RHall09/R8-O7/src/docs/html/MotorSpecs.png

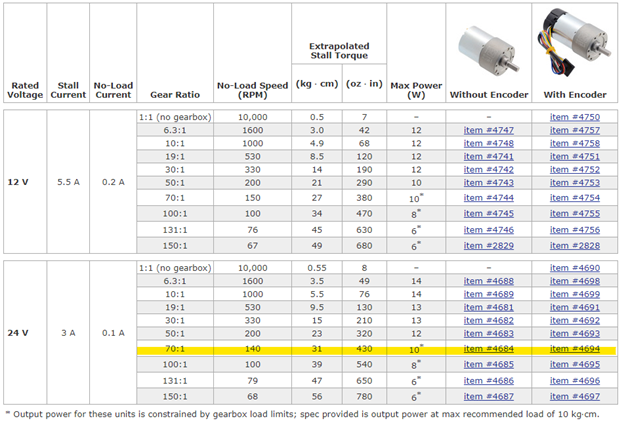
src/docs/html/MotorSpecs.png
