RHall09/R8-O7/src/Images/IMG_20211207_150913048.jpg

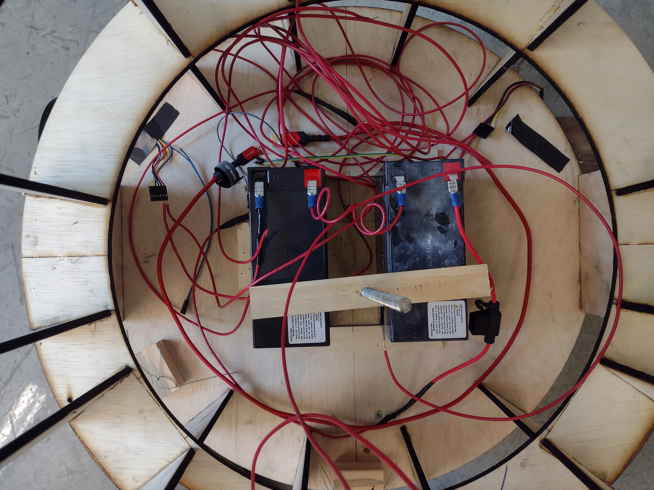
src/Images/IMG_20211207_150913048.jpg
