RHall09/R8-O7/README.md

R8-O7

A repository containing source code for running an autonomous crowd interaction robot.

See https://rhall09.github.io/R8-O7/html/index.html#sec_intro for documentation and inspirations.
