RHall09/R8-O7/src/docs/html/BabyBot.png

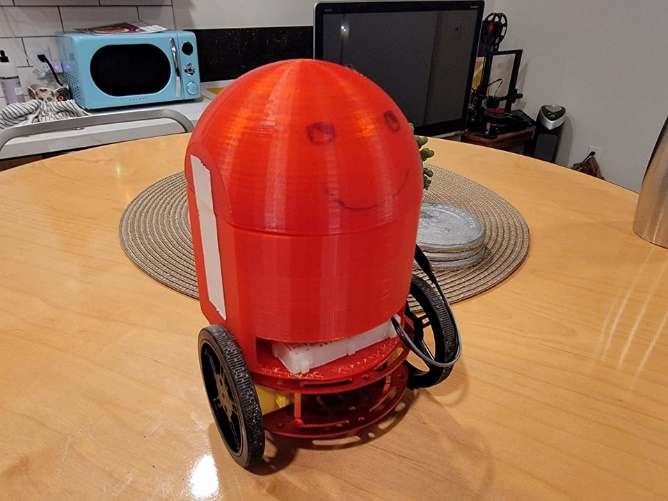
src/docs/html/BabyBot.png
