RHall09/R8-O7/src/docs/html/BluetoothGUI.png

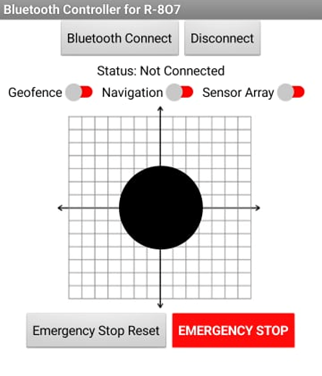
src/docs/html/BluetoothGUI.png
