RHall09/R8-O7/src/docs/html/BoardwSections.png

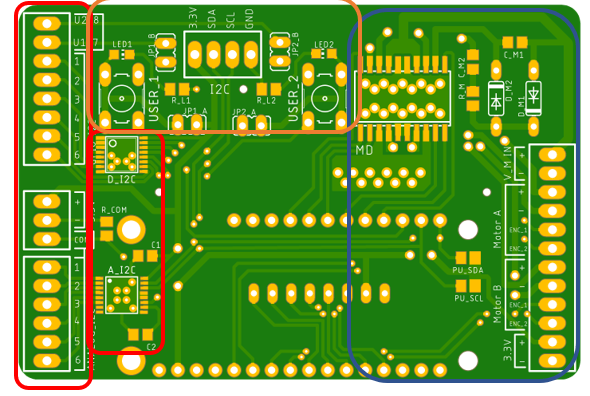
src/docs/html/BoardwSections.png
