RHall09/R8-O7/src/docs/html/BodyFrame.png

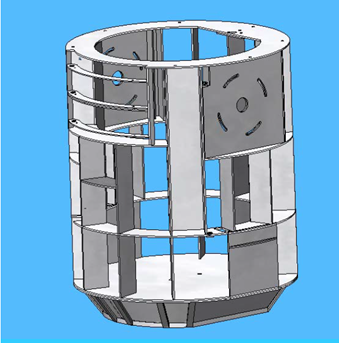
src/docs/html/BodyFrame.png
