RHall09/R8-O7/src/docs/html/CurvaturefromFence.png

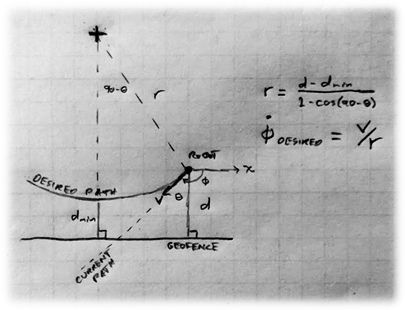
src/docs/html/CurvaturefromFence.png
