RHall09/R8-O7/src/docs/html/GeofenceTriangles.png

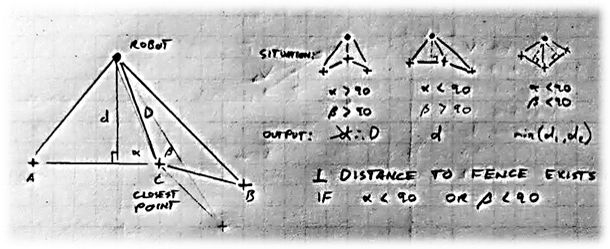
src/docs/html/GeofenceTriangles.png
