RHall09/R8-O7/src/docs/html/J4K3.png

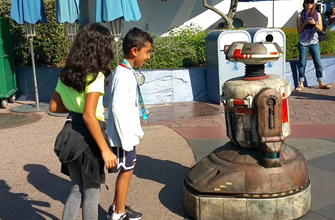
src/docs/html/J4K3.png
