RHall09/R8-O7/src/docs/html/MITCode.png

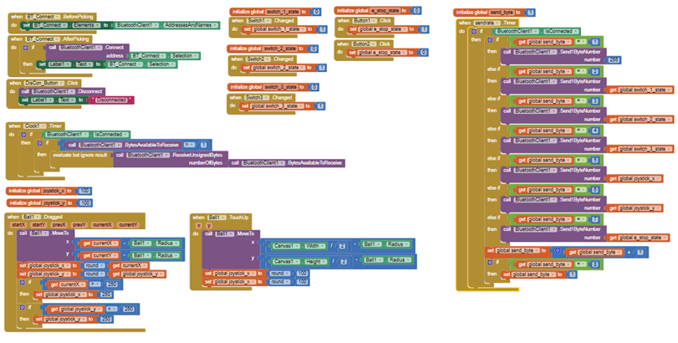
src/docs/html/MITCode.png
