RHall09/R8-O7/src/docs/html/R5Example.jpg

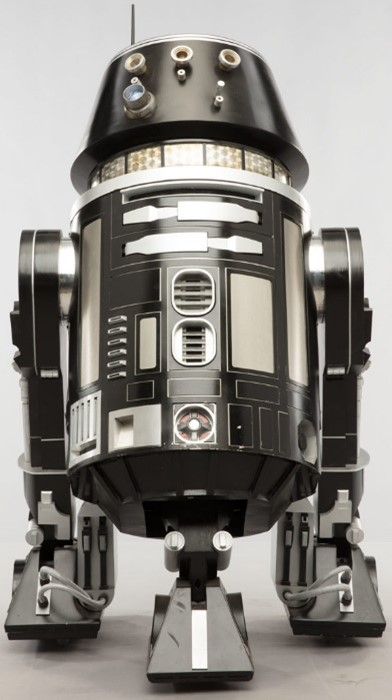
src/docs/html/R5Example.jpg
