RHall09/R8-O7/src/docs/html/TaskDiagram.png

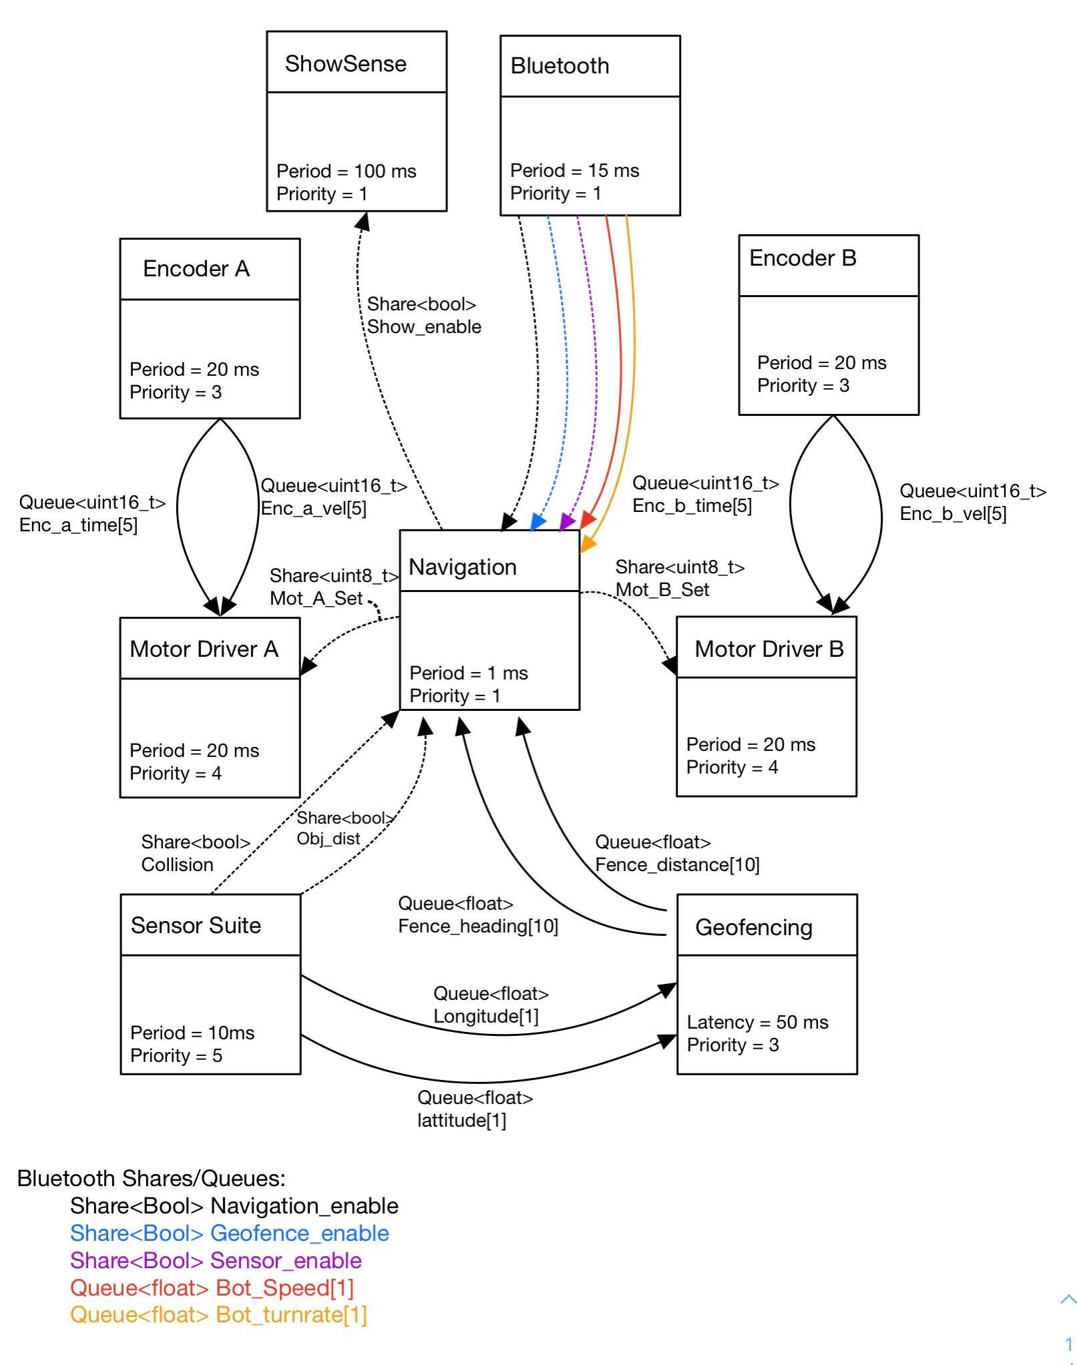
src/docs/html/TaskDiagram.png
