RHall09/R8-O7/src/Images/IMG_20211207_150856646.jpg

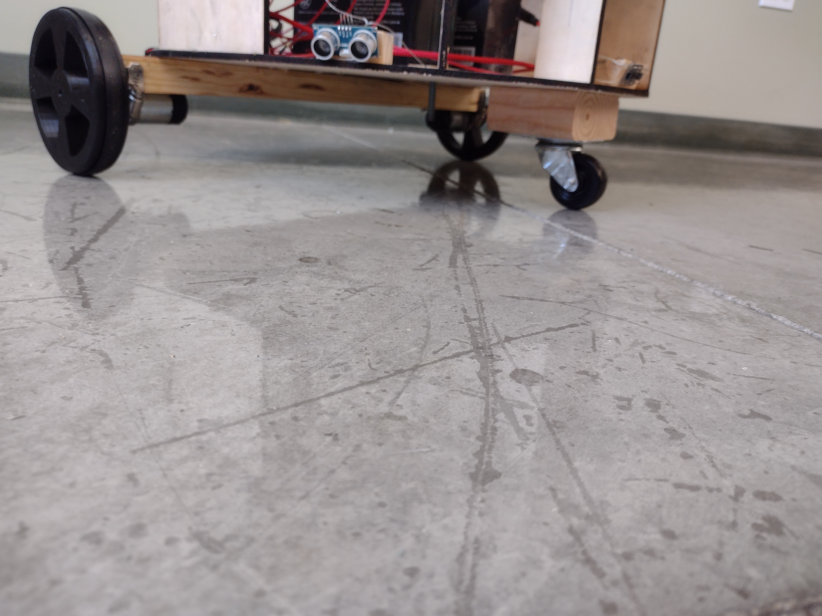
src/Images/IMG_20211207_150856646.jpg
