RHall09/R8-O7/src/Images/IMG_20211207_150905897.jpg

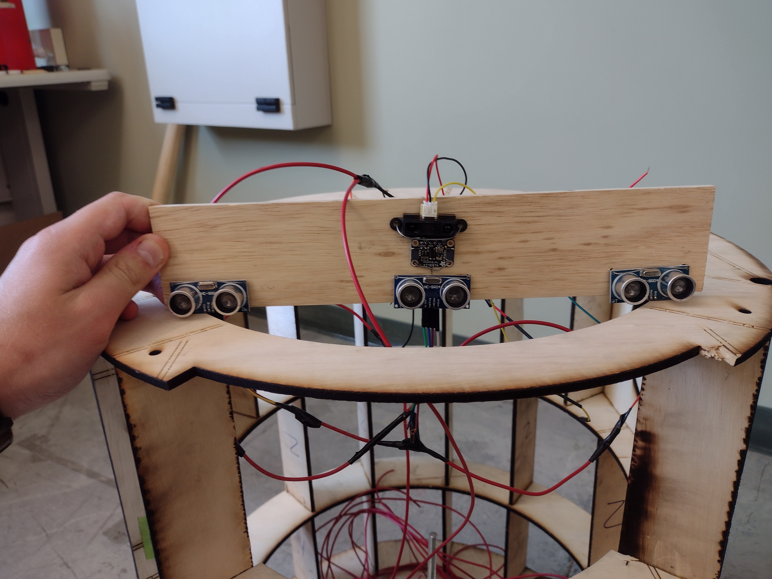
src/Images/IMG_20211207_150905897.jpg
