RHall09/R8-O7/board/R8-o7.brd

## EAGLE design board/R8-o7.brd (2021-11-02)

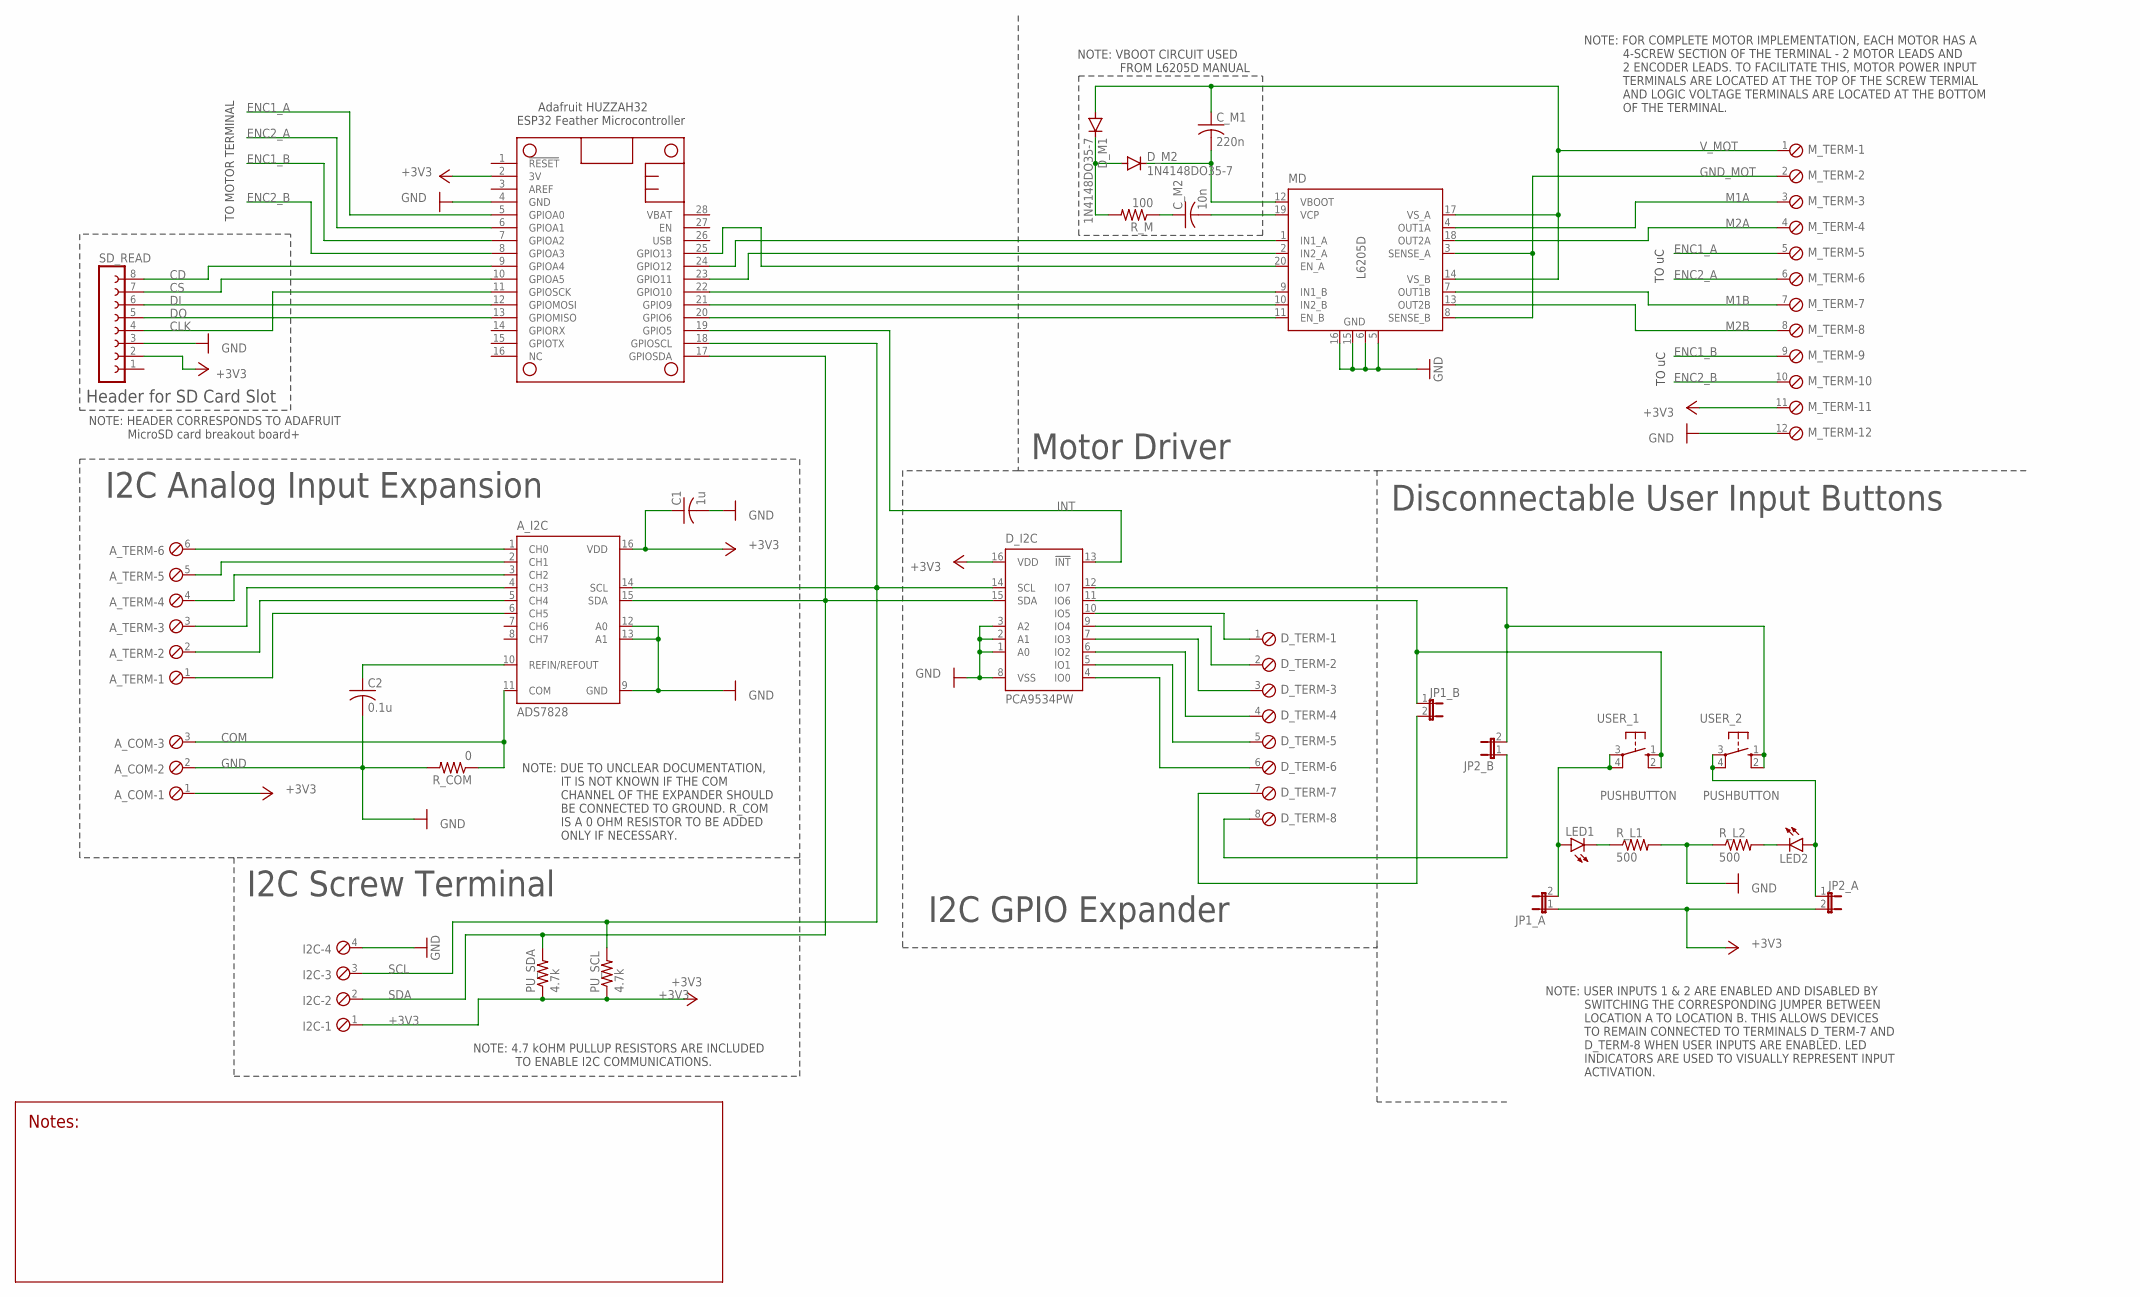
[picture p15: schematic R8-o7.sch]

Parts:
A_COM: SCREWTERM_3P_254; 3POL254
A_I2C: ADS7828; TSSOP16-PW
A_TERM: SCREWTERM_6P_254; 6POL254
C1: 1u; C0805
C2: 0.1u; C0805
C_M1: 220n; C0805
C_M2: 10n; C0805
D_I2C: PCA9534PW; TSSOP16
D_M1, D_M2: 1N4148DO35-7; DO35-7
D_TERM: SCREWTERM_8P_254; 8POL254
FTHRWNG: FEATHERWINGEXTENDED_BOTH_ENDS; FEATHERWING
I2C: SCREWTERM_4P_254; 4POL254
JP1_A, JP1_B, JP2_A, JP2_B: JP1E; JP1
LED1, LED2: LEDCHIP-LED0805; CHIP-LED0805
MD: L6205D; SO20
M_TERM: SCREWTERM_12P_254; 12POL254
PU_SCL: 4.7k; M0805
PU_SDA: 4.7k; M0805
R_COM: 0; M0805
R_L1, R_L2: 500; M0805
R_M: 100; M0805
SD_READ: FE08-1; FE08
USER_1, USER_2: PUSHBUTTON; B3F-10XX

Connections:
+3V3: A_COM.1, A_I2C.16 (VDD), C1.1, D_I2C.16 (VDD), FTHRWNG.2 (3V), I2C.1, JP1_A.1, JP2_A.2, M_TERM.11, PU_SCL.1, PU_SDA.1, SD_READ.2
CD: FTHRWNG.9 (GPIOA4), SD_READ.8
CLK: FTHRWNG.11 (GPIOSCK), SD_READ.4
COM: A_COM.3, A_I2C.11 (COM), R_COM.1
CS: FTHRWNG.10 (GPIOA5), SD_READ.7
DI: FTHRWNG.12 (GPIOMOSI), SD_READ.6
DO: FTHRWNG.13 (GPIOMISO), SD_READ.5
ENC1_A: FTHRWNG.5 (GPIOA0), M_TERM.5
ENC1_B: FTHRWNG.7 (GPIOA2), M_TERM.9
ENC2_A: FTHRWNG.6 (GPIOA1), M_TERM.6
ENC2_B: FTHRWNG.8 (GPIOA3), M_TERM.10
GND: A_COM.2, A_I2C.9 (GND), A_I2C.12 (A0), A_I2C.13 (A1), C1.2, C2.2, D_I2C.1 (A0), D_I2C.2 (A1), D_I2C.3 (A2), D_I2C.8 (VSS), FTHRWNG.4 (GND), I2C.4, MD.5 (GND), MD.6 (GND), MD.15 (GND), MD.16 (GND), M_TERM.12, R_COM.2, R_L1.2, R_L2.1, SD_READ.3
GND_MOT: MD.3 (SENSE_A), MD.8 (SENSE_B), M_TERM.2
INT: D_I2C.13 (!INT), FTHRWNG.19 (GPIO5)
M1A: MD.4 (OUT1A), M_TERM.3
M1B: MD.7 (OUT1B), M_TERM.7
M2A: MD.18 (OUT2A), M_TERM.4
M2B: MD.13 (OUT2B), M_TERM.8
unnamed: D_I2C.12 (IO7), JP2_B.2, USER_2.1 (S), USER_2.2 (S1)
unnamed: D_I2C.11 (IO6), JP1_B.1, USER_1.1 (S), USER_1.2 (S1)
unnamed: D_I2C.10 (IO5), D_TERM.1
unnamed: D_I2C.9 (IO4), D_TERM.2
unnamed: D_I2C.7 (IO3), D_TERM.3
unnamed: D_I2C.6 (IO2), D_TERM.4
unnamed: D_TERM.7, JP1_B.2
unnamed: A_I2C.1 (CH0), A_TERM.6
unnamed: A_I2C.2 (CH1), A_TERM.5
unnamed: A_I2C.3 (CH2), A_TERM.4
unnamed: A_I2C.4 (CH3), A_TERM.3
unnamed: A_I2C.5 (CH4), A_TERM.2
unnamed: A_I2C.6 (CH5), A_TERM.1
unnamed: A_I2C.10 (REFIN/REFOUT), C2.1
unnamed: FTHRWNG.20 (GPIO6), MD.11 (EN_B)
unnamed: FTHRWNG.21 (GPIO9), MD.10 (IN2_B)
unnamed: FTHRWNG.22 (GPIO10), MD.9 (IN1_B)
unnamed: FTHRWNG.23 (GPIO11), MD.2 (IN2_A)
unnamed: FTHRWNG.24 (GPIO12), MD.1 (IN1_A)
unnamed: FTHRWNG.25 (GPIO13), MD.20 (EN_A)
unnamed: JP1_A.2, LED1.A, USER_1.3, USER_1.4 (P1)
unnamed: JP2_A.1, LED2.A, USER_2.3, USER_2.4 (P1)
unnamed: LED1.C, R_L1.1
unnamed: LED2.C, R_L2.2
unnamed: D_I2C.5 (IO1), D_TERM.5
unnamed: D_I2C.4 (IO0), D_TERM.6
unnamed: D_TERM.8, JP2_B.1
unnamed: C_M2.1, R_M.1
unnamed: D_M1.C, D_M2.A, R_M.2
SCL: A_I2C.14 (SCL), D_I2C.14 (SCL), FTHRWNG.18 (GPIOSCL), I2C.3, PU_SCL.2
SDA: A_I2C.15 (SDA), D_I2C.15 (SDA), FTHRWNG.17 (GPIOSDA), I2C.2, PU_SDA.2
VBOOT: C_M1.2, D_M2.C, MD.12 (VBOOT)
VCP: C_M2.2, MD.19 (VCP)
V_MOT: C_M1.1, D_M1.A, MD.14 (VS_B), MD.17 (VS_A), M_TERM.1

Notes on the sheet:
NOTE: VBOOT CIRCUIT USED FROM L6205D MANUAL
NOTE: USER INPUTS 1 & 2 ARE ENABLED AND DISABLED BY SWITCHING THE CORRESPONDING JUMPER BETWEEN LOCATION A TO LOCATION B. THIS ALLOWS DEVICES TO REMAIN CONNECTED TO TERMINALS D_TERM-7 AND D_TERM-8 WHEN USER INPUTS ARE ENABLED. LED INDICATORS ARE USED TO VISUALLY REPRESENT INPUT ACTIVATION.
Motor Driver
Disconnectable User Input Buttons
Header for SD Card Slot
NOTE: HEADER CORRESPONDS TO ADAFRUIT MicroSD card breakout board+
I2C GPIO Expander
I2C Screw Terminal
NOTE: 4.7 kOHM PULLUP RESISTORS ARE INCLUDED TO ENABLE I2C COMMUNICATIONS.
I2C Analog Input Expansion
Adafruit HUZZAH32 ESP32 Feather Microcontroller
NOTE: DUE TO UNCLEAR DOCUMENTATION, IT IS NOT KNOWN IF THE COM CHANNEL OF THE EXPANDER SHOULD BE CONNECTED TO GROUND. R_COM IS A 0 OHM RESISTOR TO BE ADDED ONLY IF NECESSARY.
NOTE: FOR COMPLETE MOTOR IMPLEMENTATION, EACH MOTOR HAS A 4-SCREW SECTION OF THE TERMINAL - 2 MOTOR LEADS AND 2 ENCODER LEADS. TO FACILITATE THIS, MOTOR POWER INPUT TERMINALS ARE LOCATED AT THE TOP OF THE SCREW TERMIAL AND LOGIC VOLTAGE TERMINALS ARE LOCATED AT THE BOTTOM OF THE TERMINAL.
TO MOTOR TERMINAL
TO uC

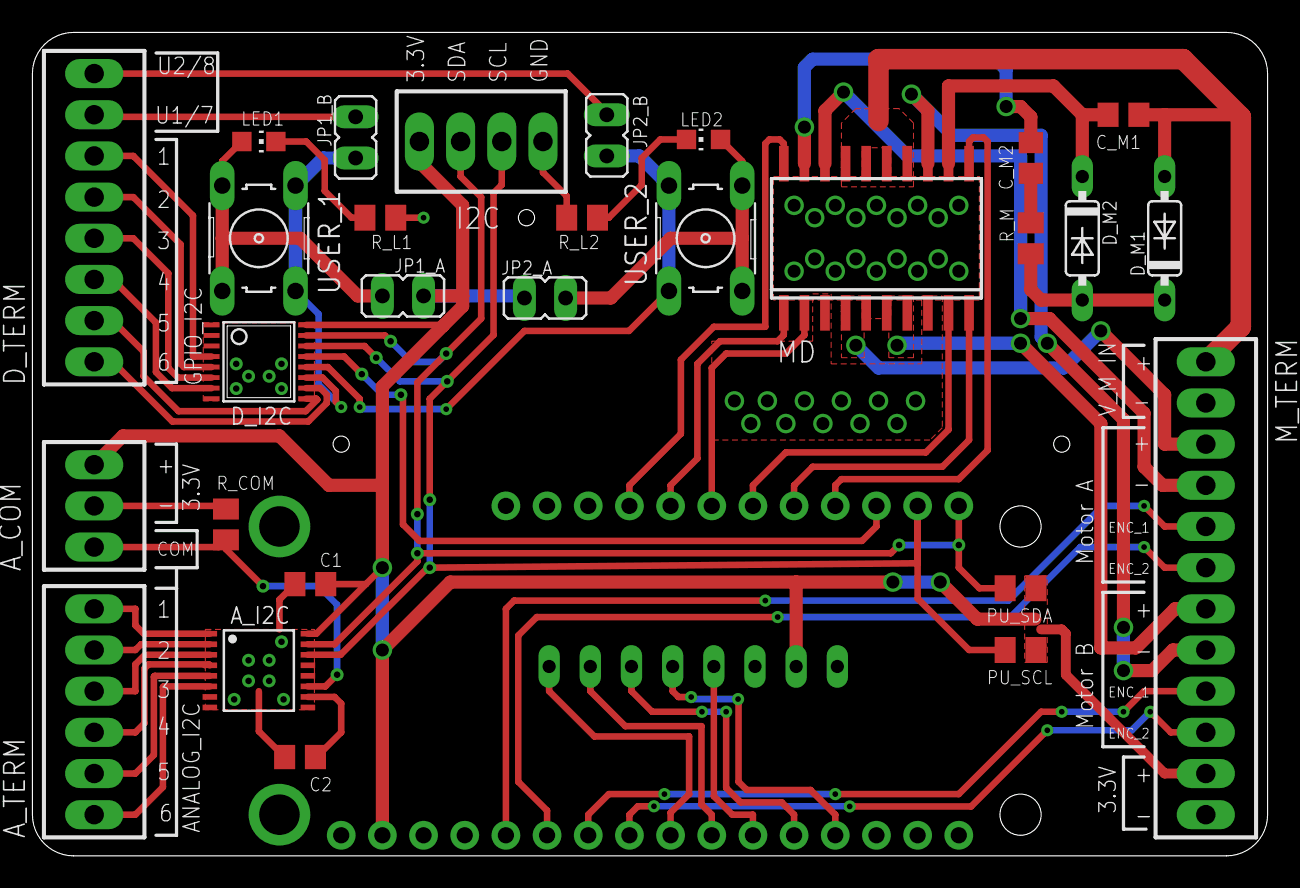
[picture p16: board R8-o7.brd from above]

Board: 2 copper layers, 76.2 x 50.8 mm, 30 parts (1 on the bottom side), 52 nets.
