RHall09/R8-O7/src/Motor_Drivers/Motor.cpp

/** @file Motor.cpp
 *  @brief Drives a motor when fed a PWM signal (+/-)
 *  @details     This file contains the member functions of a class designed to drive a motor with two PWM signals
 *      and an enable pin. This class does \b NOT implement a control loop; it simply commands the 
 *      appropriate PWM to the motor.
 * 
 * 
 *  @author Rick Hall
 *  @date 2020-4-Nov
 *  @copyright (c) 2021 by Rick Hall, released under the LGPL 3.0.
 */

#include <Arduino.h>
#include <PrintStream.h>
#include <Motor.h>

//Constructor Function

Motor::Motor(int Pin_En, int Pin_1, int Pin_2, Motor_Number mot_num)
{
    // Store motor pins 
    PinE = Pin_En;
    Pin1 = Pin_1;
    Pin2 = Pin_2;

    // For each motor, the channels will be 2*mot_num and 2*mot_num + 1
    motor_channel_1 = mot_num;
    motor_channel_2 = motor_channel_1 + 1;

    // Set pins to output mode & confirm pins set low
    pinMode(PinE, OUTPUT);
    digitalWrite(PinE, LOW);

    ledcAttachPin(Pin1, motor_channel_1);
    ledcSetup(motor_channel_1, 30000, 8);
    ledcWrite(motor_channel_1, 0);

    ledcAttachPin(Pin2, motor_channel_2);
    ledcSetup(motor_channel_2, 30000, 8);
    ledcWrite(motor_channel_2, 0);

}

//Enable Motors
void Motor::enable(void)
{
    digitalWrite(PinE, HIGH);
    enabled = true;
}
//Disable Motors
void Motor::disable(void)
{
    digitalWrite(PinE, LOW);
    enabled = false;
}
//Set both motor behaviors with PWM %s
void Motor::set(int16_t pwm)
{
    if ( (mot_error == 0) && (enabled == 1) )
    {
        uint16_t absPwm = (uint16_t)abs(pwm);

        if( (0 < pwm) && (pwm <= 255) )
        {
            ledcWrite(motor_channel_2, 0);
            ledcWrite(motor_channel_1, absPwm);

        }
        else if( (-255 <= pwm) && (pwm < 0) )
        {
            ledcWrite(motor_channel_1, 0);
            ledcWrite(motor_channel_2, absPwm);

        }
        else
        {
            ledcWrite(motor_channel_1, 0);
            ledcWrite(motor_channel_2, 0);

        } 

    }
}
//Set individual motor behavior with PWM %s
//Stop motors
void Motor::stop(void)
{
    ledcWrite(motor_channel_1, 0);
    ledcWrite(motor_channel_2, 0);
}

//Set error-overcurrent flag
void Motor::checkOvercurrent(void)
{
    if(!(digitalRead(PinE)))
    {
        mot_error = 1;
        ledcWrite(motor_channel_1, 0);
        ledcWrite(motor_channel_2, 0);   
        this -> disable();
    }
}
//Clear error-overcurrent flag
void Motor::clearOvercurrent(void)
{
    mot_error = 0;
    this -> enable();
}


//Check Flags
bool Motor::FlagChk(MotFlag flag)
{
    if(flag == ERROR)
    {
        return mot_error;
    }
    else
    {
        return enabled;
    }

}
