RHall09/R8-O7/src/Motor_Drivers/InterruptEncoder.cpp

/**  @file InterruptEncoder.cpp
 *   @brief		Member functions of a dependency of the \ref ESP32Encoder class. Allows for operation of encoders with interrupt service routines.
 *   @date Oct 8, 2020
 *   @author hephaestus
 **/


#include "InterruptEncoder.h"
void IRAM_ATTR encoderAISR(void * arg) {
	InterruptEncoder* object=(InterruptEncoder*)arg;
	long start = micros();
	long duration=start - object->microsLastA;
	if (duration >= US_DEBOUNCE) {
		object->microsLastA = start;
		object->microsTimeBetweenTicks=duration;
		object->aState = digitalRead(object->apin);
		object->bState = digitalRead(object->bpin);
		if (object->aState == object->bState)
			object->count++;
		else
			object->count--;
	}
}
InterruptEncoder::InterruptEncoder() {}
InterruptEncoder::~InterruptEncoder() {
	if(attached)
		detachInterrupt(digitalPinToInterrupt(apin));
}
int64_t  InterruptEncoder::read(){
	return count*2;
}
void InterruptEncoder::attach(int aPinNum, int bPinNum) {
	if(attached)
		return;
	apin = aPinNum;
	bpin = bPinNum;
	pinMode(apin, INPUT_PULLUP);
	pinMode(bpin, INPUT_PULLUP);
	attachInterruptArg(digitalPinToInterrupt(apin), encoderAISR,this, CHANGE);
}
