RHall09/R8-O7/src/Motor_Drivers/InterruptEncoder.h

/**  @file InterruptEncoder.h
 *   @brief		Member functions of a dependency of the \ref ESP32Encoder class. Allows for operation of encoders with interrupt service routines.
 *   @date Oct 8, 2020
 *   @author hephaestus
 **/

#ifndef INTERRUPTENCODER_H_
#define INTERRUPTENCODER_H_

#define MAX_ENCODERS 16
#define US_DEBOUNCE 10
#include <Arduino.h>

class InterruptEncoder {
private:
bool attached=false;



public:

	int apin=0;
	int bpin=0;
	InterruptEncoder();
	virtual ~InterruptEncoder();
	void attach(int aPinNum, int bPinNum);
	volatile bool aState=0;
	volatile bool bState=0;
	volatile int64_t count=0;
	volatile int64_t microsLastA=0;
	volatile int64_t microsTimeBetweenTicks=0;
	int64_t read();
};

#endif /* INTERRUPTENCODER_H_ */
