RHall09/R8-O7/src/Navigation_Drivers/nav_module.cpp

/** @file nav_module.cpp
 *  @brief   This file contains the member functions of a class for naturally driving the bot within a geofence. This class provides all motor set points unless overriden by the Bluetooth control task.
 *  @author Rick Hall
 *  @date 2021-4-Nov
 *  @copyright (c) 2021 by Rick Hall, released under the LGPL 3.0.
 **/

#include <Arduino.h>
#include <Navigation_Drivers/nav_module.h>
#include <cmath>


Navigation::Navigation(float v_cal, float t_cal)
{
    // Initialize Variables
    motor_set_A = 0;
    motor_set_B = 0;

    v_calibration = v_cal;
    t_calibration = t_cal;
}

void Navigation::nav_conv(float set_velocity, float set_turnrate)
{
    // Using calibration constants, compute motor PWM
    motor_set_A = (int16_t)round(set_velocity * v_calibration);
    motor_set_B = (int16_t)round(set_velocity * v_calibration);

    motor_set_A -= (int16_t)round(set_turnrate * t_calibration);
    motor_set_B += (int16_t)round(set_turnrate * t_calibration);

    // Overflow protection
    if ( (-255 > motor_set_A) | (motor_set_A < 255) )
    {
        if(0 <= motor_set_A)
        {
            motor_set_A = 255;
        }
        else
        {
            motor_set_A = -255;
        }
    }
    if ( (-255 > motor_set_B) | (motor_set_B < 255) )
    {
        if(0 <= motor_set_B)
        {
            motor_set_B = 255;
        }
        else
        {
            motor_set_B = -255;
        }
    }

}

int16_t Navigation::nav_A(void)
{
    return motor_set_A;
}

int16_t Navigation::nav_B(void)
{
    return motor_set_B;
}
