RHall09/R8-O7/(commit log)

2021-10-14 updated to force serial monitor speed and include adafruit motor shield library from github source
2021-10-14 updates to geobaby bot to include Adafruit MotorDriver featherwing class. Current issues with PWMServoDriver inclusion and compiling error.
    [main.cpp]
2021-10-14 Initial Draft of PCB Pin Expansion Board
    PCB project folder with schematic and board files. Many schematic errors, mostly used for verification of preliminary part sizing. If possible, larger I2C chips should be found.
    [PCB_Draft_0.brd, PCB_Draft_0.sch]
2021-10-14 With connected 3V and GND pins this time
    [PCB_Draft_0.sch]
2021-10-14 Addition of two major functionality changes: 1) allow for reading of an analog pin off the proximity sensor to measure distance to objects. 2) organize major motion profiles into functions for easy c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
    [main.cpp]
2021-10-14 Added I2C Headers
    [PCB_Draft_0.brd, PCB_Draft_0.sch]
2021-10-14 Update to baby bot: he works! This update includes averaging of IR readings to discourage random errors. Also randomized the turn radius on collision detection
    [main.cpp]
2021-10-15 Expanded board, reorganized stuff, added motor driver
    Submitted to canvas
    [PCB_Draft_0.brd, PCB_Draft_0.sch]
2021-10-18 Revert prox test to prox from battery test
    [main.cpp]
2021-10-19 Restarted schematic on larger sheet format. Added second motor driver
    [PCB_Draft_0.brd, PCB_Draft_1.brd, PCB_Draft_1.sch]
2021-10-19 Added components for MD bootstrap voltage circuit
    [PCB_Draft_1.sch]
2021-10-20 Updated main and .ini to include TinyGPS and some time modules for experimenting with nonblocking avoidance based on running time instead of delays.
    [main.cpp]
2021-10-20 Reduced to 1 MD, Airwire routing for MD
    [PCB_Draft_2.brd, PCB_Draft_2.sch]
2021-10-20 MD Screwterm labels & optimizations
    [PCB_Draft_2.brd, PCB_Draft_2.sch]
2021-10-21 BaseGPSTest: repush to fix mistake from last night. BabyGeoBot: Updated natural avoiding to function less blocky, passed parameters in, and added GPS functionality. NO geofence in place (yet)
    [main.cpp]
2021-10-21 Initial commit of UltrasonicTest materials. Queries using Arduino library HC-SR04 ultrasonic sensor
2021-10-22 Near-final draft - all wires run; checking formatting
    [PCB_Draft_2.brd, PCB_Draft_2.sch, PCB_Draft_3.brd, PCB_Draft_3.sch, PCB_Draft_4.brd, PCB_Draft_4.sch]
2021-10-22 Final-ish Version - for review
    [PCB_Draft_4.brd, PCB_Draft_4.sch]
2021-10-22 Final Version - Submitted to Canvas
    [R8-o7.brd, R8-o7.sch]
2021-10-25 Formatted .ini file and first pass at function for printing booleans! Using bit operator method since "device" is unspecified....?
2021-10-25 Semi-functional version of print_array. Sends something to the command line but not the array...
2021-10-25 Functioning version of print_array and a nice little test main.cpp Functions properly, but still want to check doxygen and float limitations
2021-10-25 Initial Commit of driver for digital i2c chip. Contains a base outline of class i2cdig with some basic constructors for debugging and the outline of some basic functions. Need to investigate what the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
2021-10-25 Initial commit of an attempt at an i2c test. Still need to set up nucleo as slave to fully test.
2021-10-26 My Anaconda Don't 🐍🐍🐍
    want none hun
2021-10-28 First draft of i2c.ccp driver. functions to: configure ports read input ports write output ports Untested.
2021-10-28 Including .h file for completed digital_i2c driver. Should be formatted correctly between .cpp and .h now
    [digital_i2c.cpp, digital_i2c.h, main.cpp]
2021-10-28 Introduction of analog_i2c files and administrative changes to digital i2c
2021-10-28 End of lab updates to start of analog driver. No major changes
2021-11-01 More Program Design & SD card stuff
    [CPPLINT.cfg]
2021-11-02 Folder Management
    [PCB_Draft_0.brd, PCB_Draft_0.sch, PCB_Draft_1.brd, PCB_Draft_1.sch, PCB_Draft_2.brd, PCB_Draft_2.sch, PCB_Draft_3.brd, PCB_Draft_3.sch]
2021-11-04 Version 1 of analog i2c drivers. Need refinement in readinput command
2021-11-19 Auto stash before revert of "Assignment Stuff"
    [main.cpp]
2021-11-26 As promised, geofencing header. Currently only has one function in it
2021-11-27 Fixed issue with EVER declaration
    [geofence_task.cpp]
2021-11-28 Push from tired kai. Not finished but updates the GPS from the featherwing. Need to give it the rest of the sensors. Should probably test the drivers before writing them into this task??? Ugh.
2021-11-28 This version has all the code to run 3 ultrasonic sensors and one of the time of flight sensors for the safety suite. It MUST be a priority task because the ultrasonic code is blocking.
2021-11-29 Lots of motor related stuff
2021-11-29 File management stuff
    (Put all driver test files in a single folder)
2021-11-29 Tasks moved into single project. Drivers not yet moved
2021-11-29 Drivers ported to project; some fixes in geofence code
    [Motor.cpp, Motor.h, MotorCS.cpp, MotorCS.h, analog_i2c.cpp, digital_i2c.cpp, digital_i2c.h, geofence_task.cpp]
2021-11-29 Updated the .gitignore to include a bunch of files that do not need to be traced. Will be adding more shortly
2021-11-29 Updated motor task code + file management
2021-11-29 Fixed error in including the wrong header in .cpp and created header for sensor_suite task.
    [sensor_suite_task.cpp, sensor_suite_task.h]
2021-11-30 Basic setup of navigation task Added boolean shares to sensor suite and geofence for toggling off for bluetooth control
2021-11-30 Fixed a comment error in digital_i2c Navigation task now reads from the appropriate queues in the sensor suite. Want to discuss # of readings and need overwrite directly to motor task if collision is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
    [digital_i2c.cpp, navigation_task.cpp]
2021-12-01 Encoder test.... i hope ...
2021-12-01 Motor drivers from when I stopped screwing with them. Nothing really works right now...
2021-12-01 Motor stuff?
2021-12-02 New motor test project
2021-12-02 Why doesn't this work
    [MotorCS.cpp]
2021-12-02 Bluetooth updates from Kai's fix
    [main.cpp]
2021-12-05 Updates to doxygen comments for I2C chip drivers.
2021-12-06 Added headers to InterruptEncoder class. No declaration of individual functions at this time.
2021-12-06 Commented MotorCS.h file. All doxycomments are there, but MotorCS.cpp could probably use some clarifying normal comments.
2021-12-06 Oops missed the class doxystring, got it now
    [MotorCS.h]
2021-12-06 All drivers are now commented out! An extra pair of eyes would be great
2021-12-06 ESP32 Drivers, if Anil needs them
2021-12-06 Comment updates to MotorCS and Nav files
2021-12-06 Added doxyfile, doxygen-awesome files, and empty mainpage. Initial run of Doxygen
    Also some doxygen comment fixes
    [MotorCS.h, encoder_A_task.cpp, encoder_A_task.h, encoder_B_task.cpp, encoder_B_task.h, motor_CS_task.cpp, motor_CS_task.h]
2021-12-07 Fixed some weird things
    [Motor.cpp, analog_i2c.cpp]
2021-12-08 Updated for complete hardware design page, updated some of landing page as well. Going to add some images to the landing page as well
2021-12-08 Repository cleared of non-essential folders
    [CPPLINT.cfg, PCB_Draft_0.brd, PCB_Draft_0.sch, PCB_Draft_1.brd, PCB_Draft_1.sch, PCB_Draft_2.brd, PCB_Draft_2.sch, PCB_Draft_3.brd]
2021-12-08 Restored PCB files
    [R8-o7.brd, R8-o7.sch]
2021-12-08 Some additional updates to the doxygen documentation. Added some photos and a logo. Also fixed a broken link in the doxyfile
    [mainpage.cpp]
2021-12-08 Cleaning the repository and putting it in the correct form for automatic documentation hosting
    [R8-o7.brd, R8-o7.sch]
2021-12-08 Fixing whatever went wrong and deleted our code
    [ESP32Encoder.cpp, ESP32Encoder.h, InterruptEncoder.cpp, InterruptEncoder.h, Motor.cpp, Motor.h, MotorCS.cpp, MotorCS.h]
2021-12-08 Fixed issue with misspelled analog_i2c
    [analog_i2c.cpp, analog_i2c.h]
2021-12-08 No more stupid merge issues Actually fixed misnamed files
    [analog_i2c.h]
